JesseLevine727/pocketai/docs/figures/m6/platforms.pdf

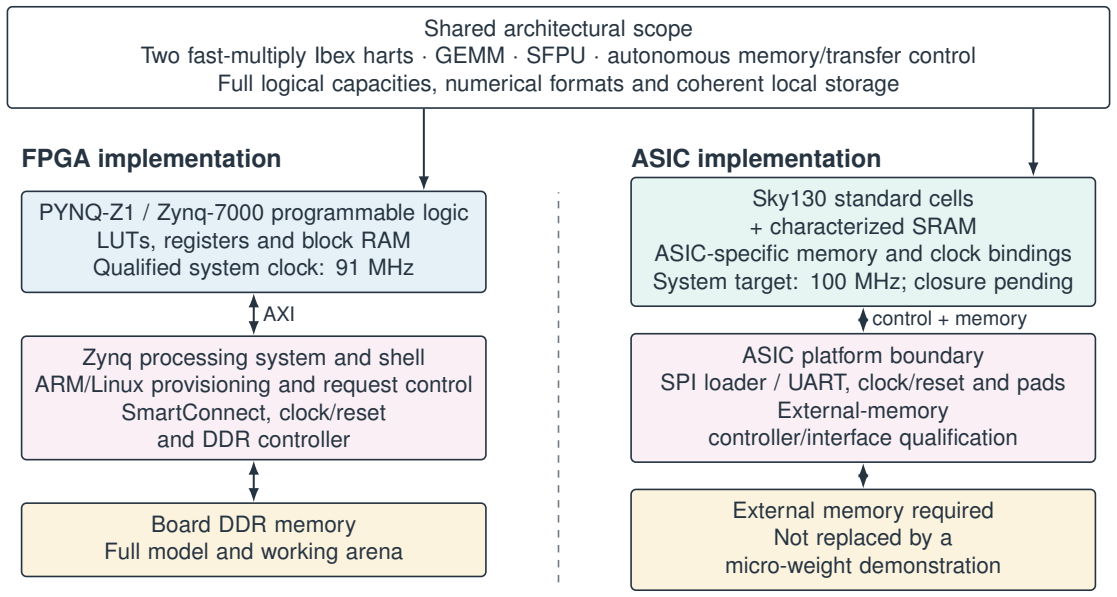
[picture p1: figure]
Shared architectural scope; FPGA implementation; ASIC implementation; PYNQ-Z1 / Zynq-7000 programmable logic LUTs, registers and block RAM Qualified system clock: 91 MHz; Sky130 standard cells + characterized SRAM ASIC-specific memory and clock bindings System target: 100 MHz; closure pending; Zynq processing system and shell ARM/Linux provisioning and request control SmartConnect, clock/reset and DDR controller; ASIC platform boundary SPI loader / UART, clock/reset and pads External-memory controller/interface qualification; AXI; control + memory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

Two fast-multiply Ibex harts · GEMM · SFPU · autonomous memory/transfer control Full logical capacities, numerical formats and coherent local storage

FPGA performance is measured on the board. ASIC area/timing are implementation-tool results; no fabricated ASIC, measured ASIC token rate or fabrication-ready claim is implied.
