JesseLevine727/pocketai/docs/M4_NUMERICS.md

# M4 model arithmetic — scaled v2 and range-safe adaptive v3

This is a **model-level representation**, composed from unchanged M3 v1
operators. It is not a change to `ref/sfpu_ref.py`, M3's packet ABI, its error
budgets, clock, or accepted overlay. Candidate implementation:
`ref/gpt2_scaled.py`. M4 quality limits were committed in `12f5386` before this
candidate was evaluated. The direct fixed-Q8 v1 failure remains preserved.

## Representations and boundaries

- Persistent activation payloads remain int16. Most tensors have logical
  value `raw / 256`. Residuals and final logits additionally carry a per-row
  exponent `e >= 0`, with logical value `raw * 2^e / 256`.
- GEMM inputs and weights are int8; reductions are exact signed int32 with
  K<=3072. No W8A16 or floating-point fabric is substituted.
- QKV and cached K/V remain Q8. K quantization uses a separate scale for each
  token; V quantization uses each feature over **only the causal prefix**.
  Future tokens cannot select the scale for an earlier output.
- Softmax remains M3's unsigned Q0.15, including positive 32768. The dynamic
  W8A8 bridge uses unsigned probabilities without signed reinterpretation.
- Embeddings, learned positions and biases come from the same pinned model.
  Final projection derives from the tied embedding weights, with a different
  quantized view after channel balancing; there are no newly trained or
  independently untied output weights.

The host study keeps int8 codes expanded to float64 for BLAS speed. This
represents all bounded integer dot-product sums exactly, as separately tested.
It is **not** a board memory layout or an acceptable 1-GiB A9 allocation.
The physical runtime must use bounded native int8 weights and scratch buffers.

## Channel balancing

For a linear input channel, choose positive `s` and replace the unquantized
linear function by `(x/s) @ (s*W)`. Train-only per-channel absolute maxima `a`
and weight-row maxima `w` give `s = a^alpha / w^(1-alpha)`, with nonzero floors.
The first development candidate uses **alpha=0.5**. A common scalar normalizes
the largest calibrated balanced activation to at most 64 and, for folded LN,
the largest gain magnitude to at most 7.5. This uses int16/gain resolution
without changing relative channel balancing. Out-of-calibration clipping is
still counted; the calibration bound is not presumed universal.

LN-to-QKV, LN-to-MLP-up and final-LN-to-vocabulary fold `gamma/s, beta/s`
into LN and `s*W` into the following weights. Attention-context and post-GELU
balancing require an explicit per-channel M3 AFFINE before requantization.
Scales are **not moved through GELU or softmax**. Weight quantization remains
symmetric, per output channel. The algebra is the idea studied by
[SmoothQuant](https://arxiv.org/abs/2211.10438v7); its published speed/quality
results are not evidence for this GPT-2/PYNQ implementation.

## Residual ranges and LayerNorm epsilon

A9 examines wide GEMM sums and their scale metadata before narrowing. The
smallest nonnegative exponent that gives at most 32700 raw magnitude is used.
For a residual addition, range selection bounds `abs(old) + abs(branch)` so
both addends and their sum fit. M3 AFFINE aligns the old residual and projects
the branch into the chosen units, followed by M3 ADD. Bias rounding and each
alignment/narrowing boundary are explicit. The headroom covers ordinary
rounding; saturation counters remain mandatory. Logits use one common exponent
across **all 50,257 vocabulary entries in each row**, not incomparable tile
scales. Wide scratch is temporary, not persistent activation storage.

Scaled LayerNorm cannot just ignore epsilon. Let `z=raw/256`, `c=2^e` and
`x=c*z`. M3 normalizes `z` with epsilon=1e-5. A9 multiplies the learned gain by

`sqrt((var(z)+epsilon) / (var(z)+epsilon/c^2))`.

This restores the desired epsilon algebra for the represented `x` before gain
quantization. The variance numerator `L*sum(raw^2)-sum(raw)^2` is computed in
integer arithmetic, avoiding subtractive floating-point cancellation. Constant
and near-constant vectors are tested. The gain is then rounded to M3 Q12.
If it exceeds the gain range, an explicit power-of-two decomposition performs
LN(gamma/factor,0), then AFFINE(factor,beta); its extra rounding is part of this
candidate. Otherwise M3's single rounding, **bias then saturation** is retained.
The fixed M3 integer square-root/epsilon rounding remains unchanged; model
quality must absorb the declared metadata/gain quantization, not hide it.

This introduces A9 variance/square-root/scale bookkeeping. It is a disclosed
hybrid assistance cost, not autonomous RISC-V inference or free computation.
Required metadata work belongs inside end-to-end inference measurements.

## Attention score centering

Rounded wide QK scores can exceed signed Q8 even when their relevant
differences are small. Before AFFINE saturation, A9 selects a common bias equal
to the negative maximum rounded raw score. This makes the maximum zero without
changing any score difference. AFFINE then saturates only far negative tails.
Such tails have differences above 32768 raw, already beyond M3's exact
4096-raw exponential cutoff; their represented probability was zero anyway.
These **intentional zero-tail clamps** are counted separately from unintended
clipping. Positive-score saturation before centering is not allowed.

## V3: bounded post-nonlinearity balancing

The 1024-token development stress found out-of-calibration overflow in block 0
context/post-GELU balancing, despite passing held-out quality on v2. V2 and its
failure evidence remain immutable. `ref/gpt2_adaptive.py` extends v2 only at
these balancing boundaries: prospectively compute the exact affine raw output
and use the original path when it fits int16. Otherwise choose a per-row
nonnegative exponent giving 32700 raw headroom and AFFINE by `1/(s*2^e)`.
Carry the unit `2^e/256` into the following dynamic-int8/GEMM scale metadata.
No nonlinear operation sees a different logical unit, and weights/calibration
are unchanged. The extra range scan is required A9 work, not excluded overhead.

V3 reproduces **all 2,048 development logits and caches exactly** from v2, and
passes the 1024-position full/chunked cache test with **zero clipping**. The
v3 source and selection evidence are frozen in `tests/m4/adaptive_candidate.json`
before requalification on the same held-out set, which now **passes** with
exactly the same reported quality metrics and all generation logit hashes.
All packed weight/metadata arrays also remain identical. V2 held-out results were
already known; this is a transparent functional correction based on development
stress, not a new blind benchmark or calibration/threshold change.

## Acceptance status and physical qualification

### Runtime batching without a numerical change

The bounded runtime batches independent dynamic-int8 columns using M3 AFFINE
with per-lane multipliers and zero bias at shift 24. This is exactly the frozen
REQUANT8 bridge, not a new quantizer: for `a=max(abs(raw))<=32768` and
`m=RNE(127*2^24/a)`, the endpoint before final RNE is within
`127 +/- 0.0009765625`. Therefore every rounded result is in [-127,127]; neither
the REQUANT8 int8 clamp nor AFFINE int16 clamp activates. Zero columns retain
multiplier zero and effective-unit fallback 1. The returned codes and scales
are unchanged. Runtime checks the bound before casting to int8.

Tests exhaust all 32,768 nonzero maxima, both signs and interior values,
unsigned probability 32768, zero columns, full shapes and packet tails. Whole
model layer/logit/KV and 60-token generation checks remain exact. Batching is
used only when it reduces descriptor count; larger row vectors retain REQUANT8.
Extra AFFINE multiplier/bias transfer planes are real traffic and must be timed.
The representative host qualification drops SFPU dispatches from 1,060,844 to
113,420 (89.3% fewer), **not a measured system-speedup claim**.

Unit tests establish scaling algebra, exact M3 affine/LN behavior, range
selection and zero-tail equivalence. Real-checkpoint cached/full-prefill and
independent float comparisons pass as recorded in `M4_VERIFICATION.md`, including
8,192 held-out predictions and all 60 generated cache/recomputation steps. The
source/calibration policy was frozen before held-out testing; thresholds were
not tuned. The compact model-pack serialization is verified. Physical-board
equivalence now passes on the exact accepted overlay: actual-operand checks,
four complete tensor cases, three 20-token generation/logit/KV sequences and
the full 1024-position/cache/overflow test. Host quality remains a separate
gate from delivered integer self-consistency. Full evidence is in
`M4_VERIFICATION.md`; actual measured performance and slowdowns are in `SPEEDUP.md`.
