JesseLevine727/pocketai/docs/evidence/m6_memory_resumed_v2/failed_leaf_disconnected.txt

┏━━━━━━━━━━━━━━━━━┳━━━━━━━━━━━━┳━━━━━━━━━━━━━━━━━━━━━━┳━━━━━━━━━━━━━━━━━━━┳━━━━━━━━━━━━━━┓
┃ Macro/Instance  ┃ Power Pins ┃ Disconnected         ┃ Signal Pins       ┃ Disconnected ┃
┡━━━━━━━━━━━━━━━━━╇━━━━━━━━━━━━╇━━━━━━━━━━━━━━━━━━━━━━╇━━━━━━━━━━━━━━━━━━━╇━━━━━━━━━━━━━━┩
│ m6_leaf_0_pre   │            │ m6_leaf_0_pre/VGND   │ m6_leaf_0_pre/A   │              │
│                 │            │ m6_leaf_0_pre/VNB    │ m6_leaf_0_pre/Y   │              │
│                 │            │ m6_leaf_0_pre/VPB    │                   │              │
│                 │            │ m6_leaf_0_pre/VPWR   │                   │              │
├─────────────────┼────────────┼──────────────────────┼───────────────────┼──────────────┤
│ m6_leaf_0_drive │            │ m6_leaf_0_drive/VGND │ m6_leaf_0_drive/A │              │
│                 │            │ m6_leaf_0_drive/VNB  │ m6_leaf_0_drive/Y │              │
│                 │            │ m6_leaf_0_drive/VPB  │                   │              │
│                 │            │ m6_leaf_0_drive/VPWR │                   │              │
├─────────────────┼────────────┼──────────────────────┼───────────────────┼──────────────┤
│ m6_leaf_1_pre   │            │ m6_leaf_1_pre/VGND   │ m6_leaf_1_pre/A   │              │
│                 │            │ m6_leaf_1_pre/VNB    │ m6_leaf_1_pre/Y   │              │
│                 │            │ m6_leaf_1_pre/VPB    │                   │              │
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
│                 │            │ m6_leaf_7_drive/VPB  │                   │              │
│                 │            │ m6_leaf_7_drive/VPWR │                   │              │
└─────────────────┴────────────┴──────────────────────┴───────────────────┴──────────────┘
