JesseLevine727/pocketai/docs/figures/m6/architecture.pdf

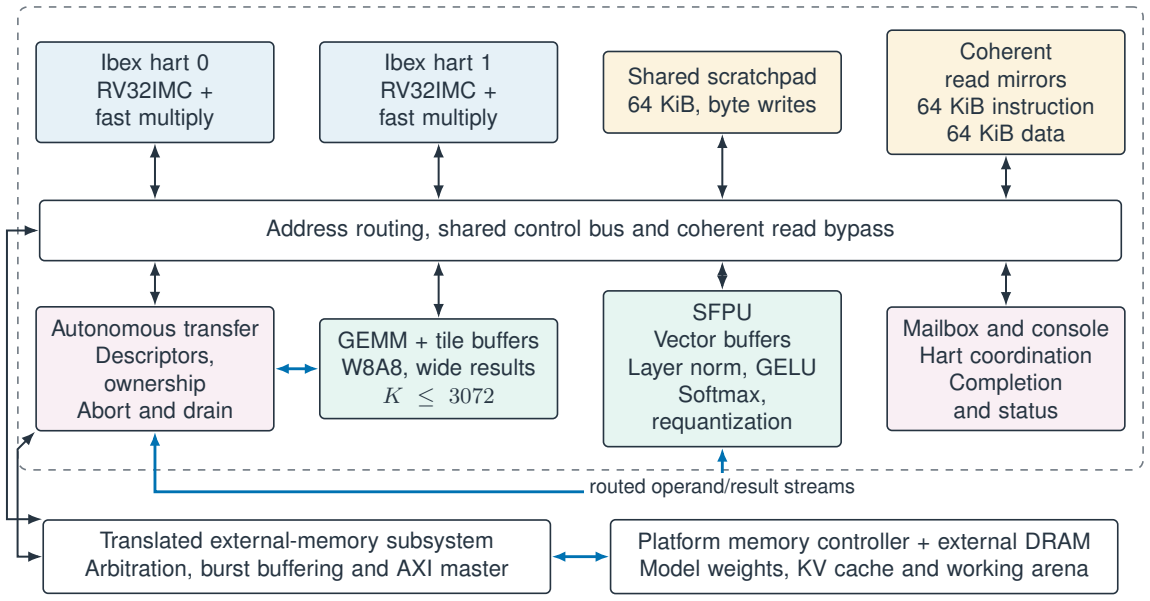
[picture p2: figure]
Ibex hart 0 RV32IMC + fast multiply; Ibex hart 1 RV32IMC + fast multiply; Shared scratchpad 64 KiB, byte writes; Coherent read mirrors 64 KiB instruction 64 KiB data; Autonomous transfer Descriptors, ownership Abort and drain; GEMM + tile buffers W8A8, wide results K ≤ 3072; SFPU Vector buffers Layer norm, GELU Softmax, requantization; Mailbox and console Hart coordination Completion and status; routed operand/result streams; Translated external-memory subsystem

Address routing, shared control bus and coherent read bypass

Arbitration, burst buffering and AXI master

Platform memory controller + external DRAM Model weights, KV cache and working arena

Portable inference compute and local storage

Functional abstraction: the central band summarizes distinct control, routing and bypass paths. External DRAM is not included in on-chip SRAM area. FPGA/ASIC bindings differ.
