JesseLevine727/pocketai/docs/figures/m6/asic_floorplan.pdf

## PocketAI: retained ASIC macro floorplan

Actual OpenDB coordinates · 292 SRAM macros · historical 2× adapter candidate

G | G | G | G | G | G | G | G | G | G | G | G | G | G | G | G | G
G | G | G | G | G | G | G | G | G | G | G | G | G | G | G | G | G
G | G | G | G | G | G | G | G | G | G | G | G | G | G | G | G | G
G | G | G | G | G | G | G | G | G | G | G | G | G | G | G | G | G
G | G | G | G | G | G | G | G | G | G | G | G | G | G | G | G | G
G | G | G | G | G | G | G | G | G | G | G | G | G | G | G | G | G
G | G | G | G | G | G | G | G | G | G | S | S | S | S | S | S | S
S | S | S | S | S | S | S | S | S | S | S | D | D | D | D | D | D
D | D | D | D | D | D | D | D | D | D | D | D | D | D | D | D | D
D | D | D | D | D | D | D | D | D | D | D | D | D | D | D | D | D
D | D | D | D | D | D | D | D | D | D | D | D | D | D | D | D | D
D | D | D | D | D | D | D | I | I | I | I | I | I | I | I | I | I
I | I | I | I | I | I | I | I | I | I | I | I | I | I | I | I | I
I | I | I | I | I | I | I | I | I | I | I | I | I | I | I | I | I
I | I | I | I | I | I | I | I | I | I | I | I | I | I | I | I | I
I | I | I | B | B | R | R | R | R | R | R | R | R | R | R | R | R
R | R | R | R | R | R | R | R | R | R | R | R | R | R | R | R | R
R | R | R

### Memory ownership

G GEMM
112 macros

S SFPU
18 macros

R Scratchpad
32 macros

I Instruction mirror
64 macros

D Data mirror
64 macros

B Burst buffer
2 macros

9.1 × 9.9 mm core frame
584 KiB physical SRAM
Both read copies included

Macro placement + PDN only Standard cells not placed
Signal routing not complete No pads in this core view
100-MHz closure: pending

Source: m6_core_physical_v4 / floorplan_v1 / OpenROAD.GeneratePDN
Labels and colors identify ownership; all macro positions and dimensions come from the retained database.
