JesseLevine727/pocketai/docs/figures/m6/asic_openroad.png

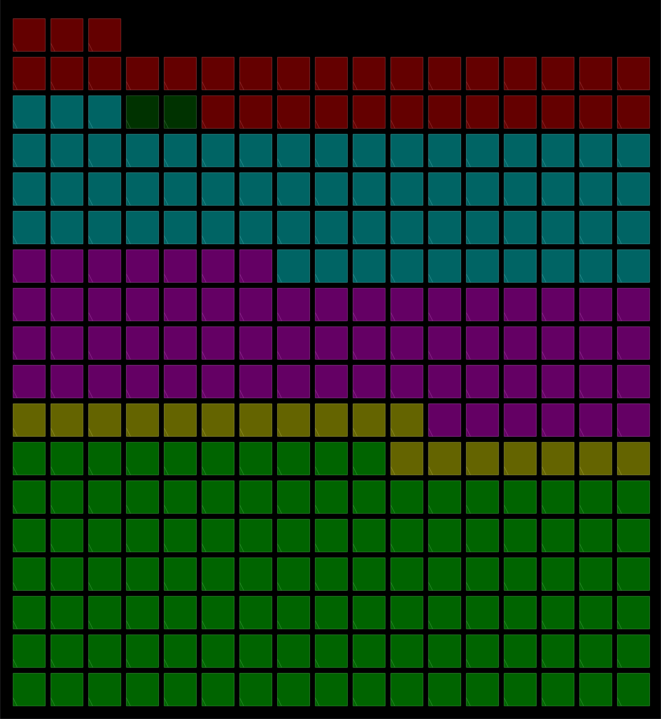
docs/figures/m6/asic_openroad.png
