JesseLevine727/pocketai/docs/m5_sweep_samples.csv

id | kind | status | role | reason | case_elapsed_seconds | bound_exceeded | prompt_tokens | new_tokens | past | profiled | model_first_token_seconds | prefill_seconds | prefill_tokens_per_second | continuation_tokens | continuation_seconds | continuation_tokens_per_second | workspace_bytes | input_bytes | output_bytes | jobs | traffic_scope | model_seconds | model_cycles | delivered_seconds | host_minus_model_seconds | model_tokens_per_second | delivered_tokens_per_second
story_g2_r1 | full | PASS | original_anchor |  | 74.62860818905756 | False | 13 | 2 |  | False | 64.27060191208791 | 64.19808389010988 | 0.2024982555905026 | 1 | 8.892870153846154 | 0.11244963467362687 | 2302532 | 368208024 | 22779400 | 35686 | packet byte counters modulo 2^32; not total DDR traffic | 73.16347561538461 | 6657876281 | 74.22159438207746 | 1.0581187666928429 | 0.027336044155609328 | 0.026946335721439944
science_g1_r1 | full | PASS | original_anchor |  | 41.571153949946165 | False | 8 | 1 |  | False | 40.37491806593407 | 40.30238657142857 | 0.19849941109123825 | 0 | 0 |  | 2187332 | 192033228 | 12931268 | 19200 | packet byte counters modulo 2^32; not total DDR traffic | 40.37492246153846 | 3674117944 | 41.42988930083811 | 1.0549668392996523 | 0.024767849423181176 | 0.024137163214186293
computing_g1_r1 | full | PASS | original_anchor |  | 41.59680227609351 | False | 8 | 1 |  | False | 40.399335395604396 | 40.328342472527474 | 0.19837165401602533 | 0 | 0 |  | 2187332 | 192033228 | 12931268 | 19200 | packet byte counters modulo 2^32; not total DDR traffic | 40.39933972527473 | 3676339915 | 41.454673684202135 | 1.055333958927406 | 0.024752879794576882 | 0.02412273239967844
cached_p13_plain_r1 | cached | PASS | injected_valid_cache |  | 13.443841483909637 | False |  | 1 | 13 | False |  |  |  |  |  |  | 2026052 | 134861772 | 1981892 | 9701 | packet word counters modulo 2^32, multiplied by 4; not total DDR traffic | 8.897048307692307 | 809631396 | 9.953339073807001 | 1.056290766114694 | 0.1123968270617806 | 0.10046879671080222
cached_p13_plain_r2 | cached | PASS | injected_valid_cache |  | 11.759177303873003 | False |  | 1 | 13 | False |  |  |  |  |  |  | 2026052 | 134861772 | 1981892 | 9701 | packet word counters modulo 2^32, multiplied by 4; not total DDR traffic | 8.896981076923076 | 809625278 | 9.955056087113917 | 1.0580750101908407 | 0.11239767639764825 | 0.10045146820362227
cached_p13_plain_r3 | cached | PASS | injected_valid_cache |  | 11.78972486173734 | False |  | 1 | 13 | False |  |  |  |  |  |  | 2026052 | 134861772 | 1981892 | 9701 | packet word counters modulo 2^32, multiplied by 4; not total DDR traffic | 8.900629362637362 | 809957272 | 10.019182230345905 | 1.1185528677085426 | 0.11235160562889546 | 0.0998085449500279
story_length_1_g1_r1 | full | PASS | synthetic_prefill_length |  | 9.938141838181764 | False | 1 | 1 |  | False | 8.557182494505495 | 8.484665582417582 | 0.11785968348266526 | 0 | 0 |  | 2026052 | 134705100 | 1966916 | 9701 | packet byte counters modulo 2^32; not total DDR traffic | 8.557186912087912 | 778704009 | 9.612499672919512 | 1.0553127608315993 | 0.11686083408875836 | 0.1040312129026351
story_length_16_g1_r1 | full | PASS | synthetic_prefill_length |  | 80.8768947427161 | False | 16 | 1 |  | False | 79.67211686813187 | 79.59960054945054 | 0.2010060338187268 | 0 | 0 |  | 2371652 | 258277836 | 25531076 | 30056 | packet byte counters modulo 2^32; not total DDR traffic | 79.67212120879121 | 7250163030 | 80.72361014643684 | 1.0514889376456296 | 0.012551441894955568 | 0.012387949426270056
story_length_32_g1_r1 | full | PASS | synthetic_prefill_length |  | 174.07728742389008 | False | 32 | 1 |  | False | 172.84272452747254 | 172.77020702197802 | 0.18521711903678678 | 0 | 0 |  | 2371652 | 522159000 | 51504520 | 62416 | packet byte counters modulo 2^32; not total DDR traffic | 172.84272886813187 | 15728688327 | 173.9044179469347 | 1.0616890788028286 | 0.00578560640964502 | 0.005750285195774271
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
