JesseLevine727/pocketai/docs/figures/m6/vivado_system.pdf

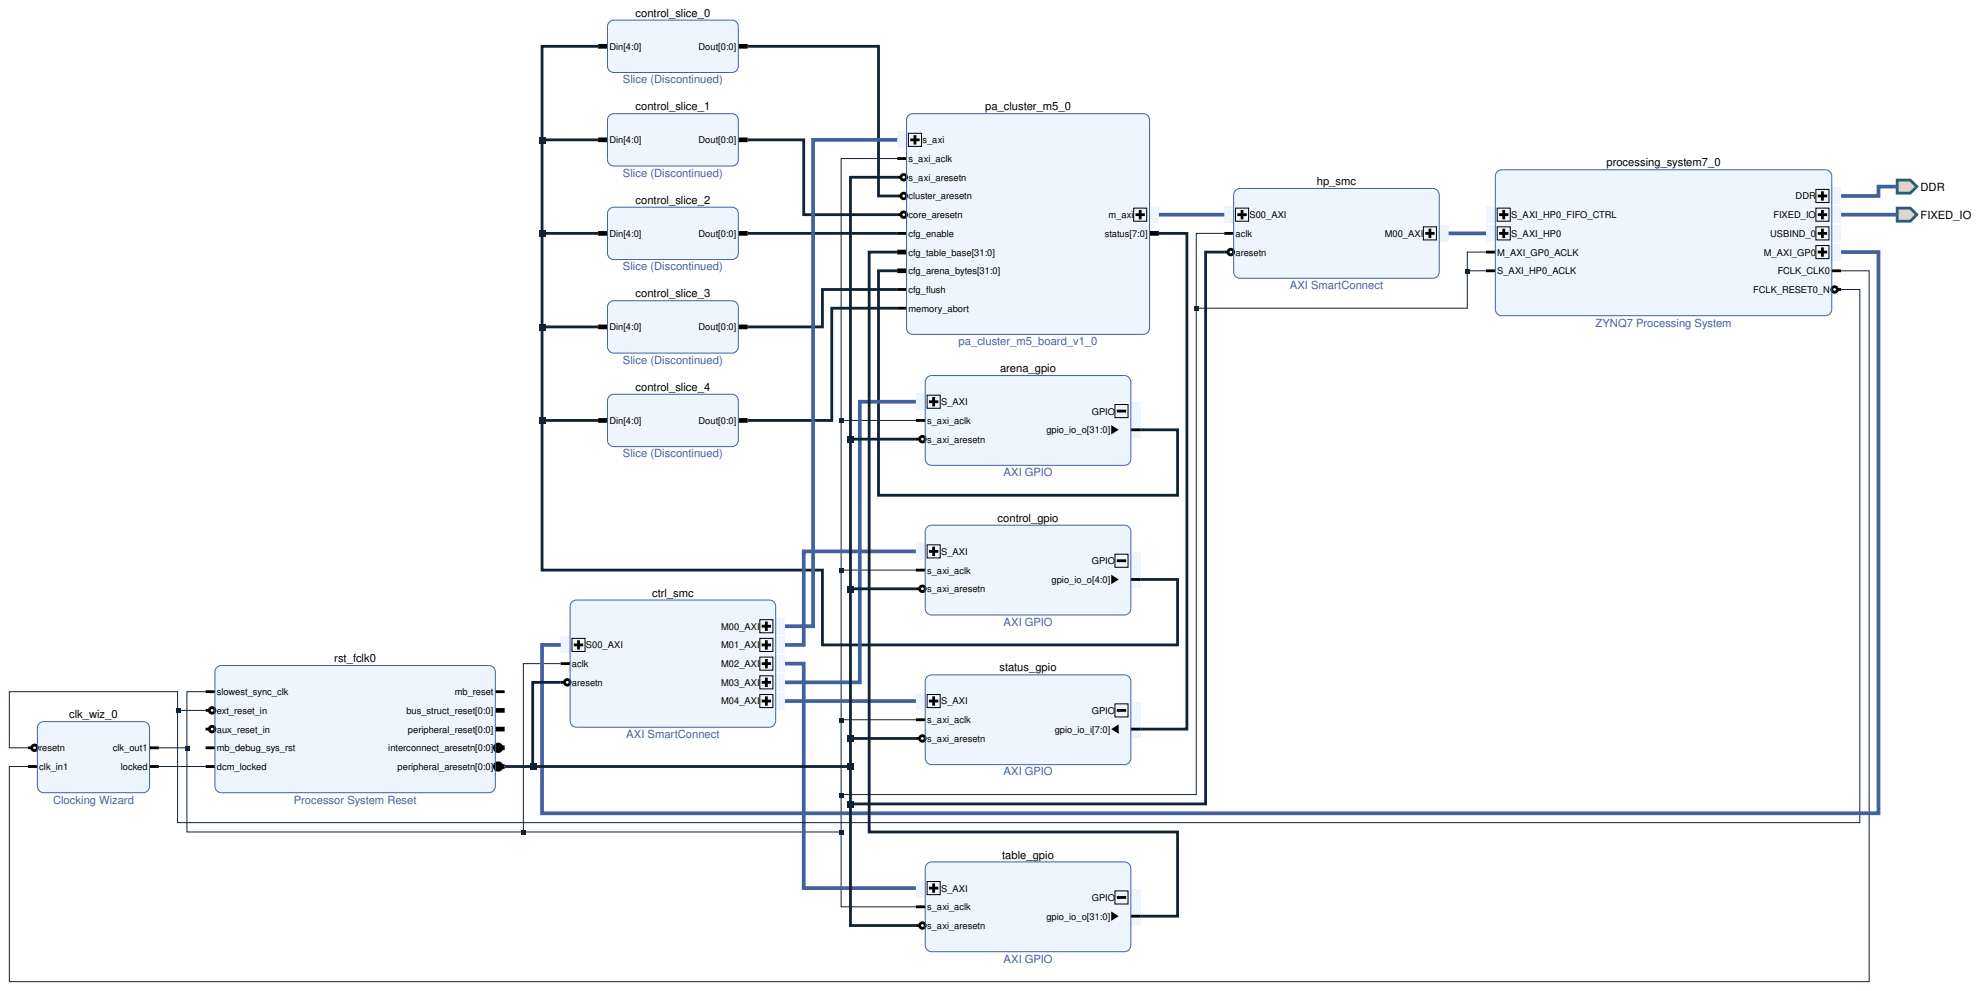
[picture p4: page 1]
clk_wiz_0; Clocking Wizard; resetn; clk_in1; clk_out1; locked; rst_fclk0; slowest_sync_clk; ext_reset_in; aux_reset_in; mb_debug_sys_rst; dcm_locked; mb_reset; bus_struct_reset[0:0]; peripheral_reset[0:0]; interconnect_aresetn[0:0]; peripheral_aresetn[0:0]; control_slice_0; Slice (Discontinued); Din[4:0]; Dout[0:0]; control_slice_1; control_slice_2; control_slice_3; control_slice_4; ctrl_smc; AXI SmartConnect; S00_AXI; M00_AXI; M01_AXI; M02_AXI; M03_AXI; M04_AXI; aclk; aresetn; pa_cluster_m5_0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

Processor System Reset
