JesseLevine727/pocketai/scripts/audit_m5_startup.py

"""Read-only startup measurement checks; collection never implies closure by itself."""
import argparse
import json
import math
from pathlib import Path
import re
import subprocess
import sys

from scripts.m5_sweep_policy import ROOT, sha
from scripts.audit_m5_sweep import require, finite_positive
from scripts.audit_m5_context import stats


def read(path):
    return json.loads((ROOT/path).read_text())


def validate_campaign(report, refs):
    p = report['policy']
    require(report['status'] == refs['status'] == 'PASS' and report['within_budget'] and
            0 < report['elapsed_seconds'] <= 3600 and p['board_budget_seconds'] == 3600 and
            p['cleanup_reserve_seconds'] == 120, 'campaign/budget gate')
    require(report['clock_hz'] == p['clock_hz'] == 91000000 and
            report['allocated_bytes'] == 266289152, 'clock/arena changed')
    require(report['normal_unload'] and not report.get('cleanup_error') and
            report['dma_after_return']['owner'] == 0 and
            all(report['info_after_close_reopen'][k] == 0 for k in ('owner', 'allocated_pages', 'pte_dma')),
            'normal ownership/page/PTE release missing')
    require(report['policy_sha256'] == refs['policy_sha256'], 'oracle/policy mismatch')
    require(all(report['sha256'][name] == value for name, value in p['pinned'].items()),
            'executed file differs from frozen policy')
    reject = report['boundary_rejection']
    require(reject['state'] == 5 and reject['error'] == 1 and reject['cache_valid'] == 17 and
            reject['generated_count'] == 19 and reject['output_sentinel_unchanged'] and
            set(reject['cache_regions_unchanged']) == {'k', 'v', 'k8', 'kunits'} and
            reject['recovery'] == 'subsequent accepted runs', 'overflow non-mutation/recovery missing')
    require([i['trial'] for i in report['trials']] == p['matrix'], 'missing/reordered trials')
    previous = None
    for item in report['trials']:
        t, r = item['trial'], item['result']
        require(item['status'] == 'PASS' and not item['bound_exceeded'] and
                0 < item['case_elapsed_seconds'] <= t['bound_seconds'] and
                item['started_campaign_seconds'] >= 0 and
                item['started_campaign_seconds']+t['bound_seconds']+120 <= 3600,
                'trial/bounded admission gate')
        if t['kind'] == 'cached':
            seed = refs['seeds'][str(t['past'])]
            expected = seed['expected']
            tokens = seed.get('prefill_tokens', [seed.get('input_token')])
            require(r['status'] == 'PASS' and r['initial_past'] == t['past'] and
                    r['input_tokens'] == tokens and r['cache_valid'] == t['past']+len(tokens) and
                    r['token'] == expected['token'] and
                    r['firmware_sha256'] == p['pinned']['m5_profile.bin'], 'cached identity/input/output')
            require(r['context_role'] == seed['context_role'], 'cached request boundary changed')
            if r['context_role'] == 'warm_last_slot':
                require(previous is not None and previous['cache_valid'] == seed['past'] and
                        previous['token'] == seed['input_token'] and
                        previous['kv_sha256'] == seed['prefill_kv_sha256'], 'hidden/future/unmatched warm state')
                require(r['derived_cache']['appended_vectors'] == 288 and
                        r['derived_cache']['updated_columns'] >= previous['derived_cache']['updated_columns'],
                        'warm state was reset')
            else:
                require(r['derived_cache']['appended_vectors'] == 144*len(tokens), 'cold/prefill row coverage')
            require(r['derived_cache']['cold_heads'] == 144, 'incomplete head coverage')
            model, delivered = r['model_seconds'], r['host_request_through_delivery_seconds']
            require(model == r['model_cycles']/91000000 and r['profile_enabled'] == t['profile'],
                    'cycle/profile boundary changed')
            require(r['workspace_high_water'] <= 2609152, 'workspace bound exceeded')
            if t['profile']:
                phases = r['phases']
                order = [(1, 0)]+[(kind, layer) for layer in range(12) for kind in range(2, 10)]
                order += [(10, 0), (11, 0), (12, 0)]
                require([(x['kind'], x['layer']) for x in phases] == order, 'phase coverage')
                for x in phases:
                    require(0 <= x['gemm_cycles']+x['sfpu_cycles'] <= x['service_cycles'] <= x['cycles'] and
                            x['cpu_remainder_cycles'] == x['cycles']-x['service_cycles'], 'nested phase accounting')
                require(sum(x['cycles'] for x in phases)+r['unassigned_profile_tail_cycles'] ==
                        r['model_cycles'], 'missing model cycles')
                for counter, seconds in (('service_cycles', 'service_seconds'),
                        ('gemm_cycles', 'gemm_compute_seconds'), ('sfpu_cycles', 'sfpu_compute_seconds')):
                    require(sum(x[counter] for x in phases)/91000000 == r[seconds], 'nested service totals')
                require(math.isclose(r['service_seconds']+r['cpu_remainder_seconds'], model, abs_tol=1e-9),
                        'model/service sum')
                details = r['startup_detail']
                require(all(x['seconds'] == x['cycles']/91000000 for x in details), 'detail cycle conversion')
                if r['derived_cache'].get('version', 1) == 2:
                    require(len(details) == 16, 'missing deferred first-use counters')
                    cold = r['context_role'] != 'warm_last_slot'
                    for index, count in {0: 144 if cold else 0, 13: 12,
                                         14: 144 if cold else 0, 15: 144*len(tokens)}.items():
                        require(details[index]['calls'] == count, 'first-use coverage')
                    required = details[13]['seconds']+details[14]['seconds']
                    require(r['initial_required_derived_seconds'] == required and 0 <= required <= model and
                            details[14]['cycles'] <= details[15]['cycles'], 'hidden first-demand work')
            else:
                require(not r['phases'] and r['service_seconds'] is None and
                        'startup_detail' not in r, 'profile contaminated plain sample')
            previous = r
        else:
            require(t['kind'] == 'full', 'unknown trial type')
            case = refs['cases'][t['case']]
            count = t['new_tokens']; expected = case['steps'][count-1]
            require(r['id'] == case['id'] and r['prompt_tokens'] == case['input_tokens'] and
                    r['generated_tokens'] == [x['token'] for x in case['steps'][:count]] and
                    r['cache_valid'] == len(case['input_tokens'])+count-1, 'original request changed')
            image = 'm5_trace.bin' if t['capture'] else 'm5_runtime.bin'
            require(r['execution_image'] == image and r['firmware_sha256'] == p['pinned'][image],
                    'full request image changed')
            if t['capture']:
                baseline = read('build/m5_startup_split_fixed_diag_v1/campaign.json')
                expected_trace = next(x['result']['traces'] for x in baseline['trials']
                                      if x['trial'].get('capture'))
                require(r['traces'] == expected_trace, 'original story tensors changed')
            model, delivered = r['firmware_seconds'], r['request_through_delivery_seconds']
            require(len(r['decode_seconds']) == count-1 and
                    math.isclose(r['ttft_seconds']+sum(r['decode_seconds']), model, abs_tol=.001) and
                    r['request_tokens_per_second'] == count/delivered, 'full-request accounting')
            require(r['work_high_water'] <= 2609152, 'full request workspace bound')
            previous = None
        require(finite_positive(model) and finite_positive(delivered) and
                model < delivered <= item['case_elapsed_seconds'], 'invalid delivery interval')
        require(r['logits_sha256'] == expected['logits_sha256'] and
                r['kv_sha256'] == expected['cache_sha256'], 'all logits/complete valid KV mismatch')


def validate_final(reports, references, selection, binaries, overlay):
    """Every selected repetition must pass; averages cannot conceal a miss."""
    all_full = []
    for prefix in ('story', 'science'):
        key = selection['final_'+prefix]
        report = reports[key]; refs = references[key]
        require(refs['case'] == prefix, 'independent prefix changed')
        pinned = report['policy']['pinned']
        require(all(pinned[n] == overlay[n] for n in overlay), 'final hardware identity')
        require(all(pinned[n] == binaries[n] for n in ('m5_runtime.bin', 'm5_profile.bin', 'm5_trace.bin')),
                'final firmware identity')
        for past, limit in ((1022, 20.0), (1023, 10.0)):
            group = [x for x in report['trials'] if x['trial'].get('past') == past]
            require(len(group) >= 3 and all(not x['trial']['profile'] and
                    x['result']['derived_cache'].get('version') == 2 and
                    x['result']['host_request_through_delivery_seconds'] <= limit for x in group),
                    'cold/warm repeated per-sample performance gate')
        all_full += [x for x in report['trials'] if x['trial']['kind'] == 'full']
        diagnostic = reports[selection['diagnostic_'+prefix]]
        require(references[selection['diagnostic_'+prefix]]['case'] == prefix, 'diagnostic prefix')
        require(diagnostic['policy']['pinned']['m5_profile.bin'] == binaries['m5_detail.bin'] and
                all(diagnostic['policy']['pinned'][n] == overlay[n] for n in overlay), 'diagnostic image')
        cold = [x for x in diagnostic['trials'] if x['trial'].get('past') == 1022]
        require(cold and all(x['trial']['profile'] and
                x['result']['initial_required_derived_seconds'] <= 10.0 and
                x['result']['host_request_through_delivery_seconds'] <= 20.0 for x in cold),
                'cold initialization diagnostic gate')
    for name, tokens, seconds in (('science', 1, 10.0), ('computing', 1, 10.0), ('story', 2, 20.0)):
        group = [x for x in all_full if x['trial']['case'] == name and not x['trial']['capture']]
        require(len(group) >= 3 and all(x['trial']['new_tokens'] == tokens and
                x['result']['request_through_delivery_seconds'] <= seconds for x in group),
                'original short-request repeated performance gate: '+name)
    require(any(x['trial']['case'] == 'story' and x['trial']['capture'] for x in all_full),
            'final original physical story trace missing')


def validate_stage(stage):
    stage = Path(stage)
    report, refs = read(stage/'campaign.json'), read(stage/'references/manifest.json')
    validate_campaign(report, refs)
    validate_references(refs)
    layout = Path('build/m5_arena.1Org4t/model/layout.json')
    require(report['sha256']['model.bin'] == read(layout)['model_sha256'] and
            report['sha256']['layout.json'] == sha(ROOT/layout), 'complete model/layout identity changed')
    require(report['policy'] == read(stage/'policy.json') and
            report['policy_sha256'] == sha(ROOT/stage/'policy.json') and
            report['reference_manifest_sha256'] == sha(ROOT/stage/'references/manifest.json'),
            'measured policy/reference binding')
    for name, digest in report['policy']['pinned'].items():
        path = ROOT/stage/'deployed'/name if name.endswith('.py') else ROOT/report['policy']['source_paths'][name]
        require(sha(path) == digest, 'historical deployed artifact changed: '+str(path))
    return report, refs


def validate_references(refs):
    require(refs['case'] in ('story', 'science'), 'unknown independent prefix')
    directory = 'build/m5_context_'+refs['case']+'_reference_v'+('2' if refs['case'] == 'story' else '1')
    canonical = read(directory+'/manifest.json')
    for past in ('1022', '1023'):
        require(refs['seeds'][past] == canonical['seeds'][past], 'independent maximum-context oracle changed')
    fixtures = {x['id']: x for x in read('build/m4_runtime_fixtures/manifest.json')['generation']}
    require(refs['cases'] == fixtures, 'original full-request oracles changed')
    prompt = refs['seeds']['0']
    require(any(prompt['prefill_tokens'] == case['input_tokens'] and prompt['expected'] == case['steps'][0]
                for case in fixtures.values()), 'actual prefill oracle changed')


def hardware_from_reports(directory, reset_count=9, data_read_mirror=False):
    def text(name): return (ROOT/directory/'reports'/name).read_text()
    timing = text('m5_timing_summary.rpt')
    m = re.search(r'WNS\(ns\).*?\n\s*-+[^\n]*\n\s*([^\n]+)', timing, re.S)
    require(m, 'missing timing summary')
    v = m[1].split()
    result = dict(wns_ns=float(v[0]), tns_ns=float(v[1]), hold_ns=float(v[4]), ths_ns=float(v[5]), clock_mhz=91)
    require('10.989          91.000' in timing and
            len(set(re.findall(r'\d+\. checking \w+ \(0\)', timing))) == 12 and
            'All user specified timing constraints are met.' in timing, 'timing constraints incomplete')
    route = text('m5_route_status.rpt')
    counts = [int(re.search(label+r'\.+\s*:\s*(\d+)', route)[1]) for label in
              ('# of routable nets', '# of fully routed nets', '# of nets with routing errors')]
    require(counts[0] == counts[1] and counts[0] > 0 and counts[2] == 0, 'incomplete routing')
    result['routed_nets'] = counts[0]
    utilization = text('m5_utilization.rpt')
    for key, label in (('luts', 'Slice LUTs'), ('registers', 'Slice Registers'),
                       ('bram36', 'Block RAM Tile'), ('dsp', 'DSPs'), ('slices', 'Slice')):
        found = re.search(r'\|\s*'+label+r'\s*\|\s*([\d.]+)\s*\|', utilization)
        require(found, 'missing utilization '+label); result[key] = float(found[1])
    for name, rule, count in (('m5_drc.rpt', 'RTSTAT-10', 1), ('m5_methodology.rpt', 'LUTAR-1', reset_count)):
        rules = re.findall(r'^\|\s*([A-Z][A-Z0-9-]+)\s*\|\s*(Warning|Error|Critical Warning)\s*\|[^\n]+?\|\s*(\d+)\s*\|', text(name), re.M)
        require(rules == [(rule, 'Warning', str(count))], 'unreviewed DRC/methodology finding')
    require(result['wns_ns'] >= .250 and result['tns_ns'] == 0 and result['hold_ns'] > 0 and
            result['ths_ns'] == 0 and result['dsp'] == 0 and
            result['bram36'] == (127.5 if data_read_mirror else 111.5),
            'hardware timing/resource gate')
    config = text('m5_fast_synth_configuration.rpt')
    for hart in (0, 1):
        require(f'hart={hart} multiplier=RV32MFast cells=91' in config, 'two fast harts not proven')
    require('fetch_mirror_bytes=65536 bram36=16 bram18=0' in config, 'unexpected instruction mirror')
    if data_read_mirror:
        require('data_read_mirror_bytes=65536 bram36=16 bram18=0' in config,
                'dedicated data-read bank not proven')
    for name in ('m5_pynq.bit', 'm5_pynq.hwh', 'm5_pynq_final.dcp'):
        require((ROOT/directory/name).is_file(), 'no qualified final '+name)
    return result


def manifest_paths():
    sources = set()
    for pattern in ('runtime/m5_startup/*', 'scripts/*m5_startup*', 'zynq/*m5_startup*',
                    'tests/m5_startup/*', 'docs/M5_STARTUP*.md'):
        sources.update(str(p.relative_to(ROOT)) for p in ROOT.glob(pattern) if p.is_file())
    artifacts = set()
    for directory in ROOT.glob('build/m5_startup_*'):
        entries = directory.rglob('*') if directory.is_dir() else (directory,)
        for p in entries:
            # Historical stage symlinks can target current Python sources.
            # Archive actual deployed files instead; canonical immutable binary
            # targets and each policy's exact identity are checked separately.
            if p.is_file() and not p.is_symlink() and '__pycache__' not in p.parts:
                artifacts.add(str(p.relative_to(ROOT)))
    return sources, artifacts


def summarize(reports):
    result = {}
    for name, report in reports.items():
        r = dict(status=report['status'], elapsed_seconds=report['elapsed_seconds'], cached={}, full=[])
        for role in ('cold_initialization_in_model', 'warm_last_slot', 'actual_prompt_prefill'):
            samples = [x['result'] for x in report['trials'] if x['trial']['kind'] == 'cached' and
                       x['result']['context_role'] == role]
            if samples:
                r['cached'][role] = dict(delivered=stats([x['host_request_through_delivery_seconds'] for x in samples]),
                    model=stats([x['model_seconds'] for x in samples]),
                    initial_required_seconds=[x['initial_required_derived_seconds'] for x in samples
                                              if 'initial_required_derived_seconds' in x])
        for item in report['trials']:
            t, x = item['trial'], item['result']
            if t['kind'] == 'full':
                r['full'].append(dict(id=t['id'], case=t['case'], output_tokens=t['new_tokens'],
                    trace=t['capture'], model_seconds=x['firmware_seconds'],
                    delivered_seconds=x['request_through_delivery_seconds'],
                    delivered_output_tokens_per_second=t['new_tokens']/x['request_through_delivery_seconds']))
        result[name] = r
    return result


NATIVE = {'attention_test.log': 'M5 SCALAR ATTENTION LAYOUT EXACT PASS 15',
    'native_test.log': 'M5 NUMERICAL FOUNDATION PASS',
    'ready_test.log': 'STARTUP LAZY CONTRACT PASS 32',
    'combined_test.log': 'CONTEXT COMBINED SCORES EXACT PASS 84',
    'ops_test.log': 'STARTUP GENERIC SCALAR EXACT PASS 96',
    'bounded_test.log': 'STARTUP BOUNDED PRODUCT EXACT PASS 462147',
    'word_test.log': 'STARTUP WORD AFFINE EXACT PASS 300000',
    'project_test.log': 'STARTUP FUSED PROJECT EXACT PASS 1776 accepted rows; 1686 fallback',
    'product_test.log': 'STARTUP PRODUCT TWO-ROUNDING EXACT PASS 330000',
    'batch_test.log': 'STARTUP BATCH EXACT PASS 20 accepted; 120 rejections',
    'fixed_test.log': 'STARTUP FIXED FACTOR EXACT PASS 500000'}
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
