JesseLevine727/pocketai/scripts/m5_startup_fetch.py

"""Coherent local instruction mirror; preserve all frozen CPU/router/bus sources."""
import argparse
import json
from pathlib import Path
import sys
import yaml
if __package__ in (None, ''):
    sys.path.insert(0, str(Path(__file__).resolve().parents[1]))
from scripts.m5_fast_sources import ROOT, WRAPPER, CLUSTER, derived_wrapper, pinned, digest, pipelined_multiplier
from scripts.m5_fast_sources import board_tcl as parent_board_tcl
from scripts.m5_iterate_sources import once
from scripts.check_m5_sources import check as check_lsu

TOP = 'src/pocketai_pa_pa_m5_rtl_0.1/pa_m5_cluster_top.sv'
MEMORY = Path(TOP).parent
ROUTER_SHA = '73e114d4902ed1ef4bce5bf5df108cd3c02caf402e84d7f5de49836419bdbbdb'
SYSTEM_SHA = 'ad235f2ad95ba0de0352e170f3e5f4e7111beda52284ac6a315cbe344bc125e9'


def direct_router(early=False, prefetch=False):
    if early and prefetch: raise ValueError('distinct instruction experiments')
    source = pinned(ROOT/'rtl/m5/pa_m5_obi_router.sv', ROUTER_SHA).decode()
    source = once(source, 'module pa_m5_obi_router (',
                  'module pa_m5_obi_router #(parameter bit DirectResponse = 1\'b0) (')
    source = once(source, 'assign host_gnt_o = state_q == Idle && host_req_i && !stop_i;',
        '''// Only instruction ports opt in. A completed owned response may hand
  // the single request slot directly to a new request at the SAME edge.
  // Stop/abort always prevents new admission, never discards old ownership.
  assign host_gnt_o = (state_q == Idle ||
      (DirectResponse && state_q == WaitResponse && target_rvalid_i[route_q])) &&
      host_req_i && !stop_i;''')
    source = once(source, 'assign host_rvalid_o = state_q == Respond;',
        'assign host_rvalid_o = DirectResponse ? (state_q == WaitResponse && target_rvalid_i[route_q]) : state_q == Respond;')
    source = once(source, 'assign host_rdata_o = response_q;',
        'assign host_rdata_o = DirectResponse ? target_rdata_i[route_q] : response_q;')
    source = once(source, 'assign host_err_o = error_q;',
        'assign host_err_o = DirectResponse ? target_err_i[route_q] : error_q;')
    source = once(source, '        state_q <= Respond;', '''        if (DirectResponse) begin
          if (host_gnt_o) begin
            route_q <= host_addr_i[31:28] == 4'h4;
            addr_q <= host_addr_i; data_q <= host_wdata_i;
            we_q <= host_we_i; be_q <= host_be_i;
            state_q <= Send;
          end else state_q <= Idle;
        end else state_q <= Respond;''')
    source = once(source, 'endmodule', '''`ifndef SYNTHESIS
  logic owned_q;
  always_ff @(posedge clk_i) begin
    if (!rst_ni) owned_q <= 0;
    else begin
      assert (!host_rvalid_o || owned_q);
      assert (!host_gnt_o || !owned_q || host_rvalid_o);
      assert (!host_gnt_o || !stop_i);
      if (host_gnt_o) owned_q <= 1;
      else if (host_rvalid_o) owned_q <= 0;
    end
  end
`endif
endmodule''')
    if early:
        source = once(source, "parameter bit DirectResponse = 1'b0",
                      "parameter bit DirectResponse = 1'b0, parameter bit EarlyLocal = 1'b0")
        source = once(source, '''  assign host_gnt_o = (state_q == Idle ||
      (DirectResponse && state_q == WaitResponse && target_rvalid_i[route_q])) &&
      host_req_i && !stop_i;''', '''  logic can_admit, early_local;
  initial assert (!EarlyLocal || DirectResponse);
  assign can_admit = state_q == Idle ||
      (DirectResponse && state_q == WaitResponse && target_rvalid_i[route_q]);
  // Only a RAM instruction may issue at admission. Its grant means the mirror
  // actually accepted the read, including write-priority backpressure. Other
  // addresses retain the registered Send stage and original owned lifetime.
  assign early_local = EarlyLocal && can_admit && host_addr_i[31:16] == 0;
  assign host_gnt_o = can_admit && host_req_i && !stop_i &&
      (!early_local || target_gnt_i[0]);''')
        source = once(source, "assign target_req_o[0] = state_q == Send && !route_q;",
            "assign target_req_o[0] = (state_q == Send && !route_q) || (early_local && host_req_i && !stop_i);")
        for signal, old, new in (('addr', 'addr_q', 'host_addr_i'), ('we', 'we_q', 'host_we_i'),
                                 ('be', 'be_q', 'host_be_i'), ('wdata', 'data_q', 'host_wdata_i')):
            source = once(source, f'assign target_{signal}_o = {old};',
                          f'assign target_{signal}_o = early_local ? {new} : {old};')
        if source.count('state_q <= Send;') != 2: raise ValueError('ambiguous admission states')
        source = source.replace('state_q <= Send;', 'state_q <= early_local ? WaitResponse : Send;')
    if prefetch:
        source = once(source, "parameter bit DirectResponse = 1'b0",
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
