JesseLevine727/pocketai/(commit log)

2026-09-05 m3: integrate pipelined integer SFPU and full-shape verified chains
2026-09-05 m3: record timing shortfall and harden physical qualification harness
    [m3_run.py]
2026-09-05 m4: pin GPT-2 references and expose fixed-range quantization failures
    [fetch_m4_data.py, fetch_m4_model.py]
2026-09-05 m4: qualify held-out W8A8 quality and compact pack; retain long-context range failure
    [export_m4_pack.py]
2026-09-05 m4: implement bounded native and FPGA runtime with independent physical fixtures
    [m4_driver.py, m4_offload.py, m4_run.py, stage_m4_runtime.py]
2026-09-05 m4: batch exact dynamic bridges and pass physical DMA recovery controls
2026-09-05 m4: freeze same-board performance sampling and honest timing boundaries
2026-09-05 m4: audit required physical evidence and reject incomplete or mismatched benchmark samples
2026-09-05 m4: derive honest performance statistics from complete validated raw samples
2026-09-06 m5: qualify actual dual-Ibex DDR and correct delayed-memory core hazards
    Keep staged first-word strobes until grant and gate branch decisions with actual ID execution. Apply hash-checked derivations only to M5 exported sources; frozen dependency trees remain pinned. Add real-hart faults/offsets/abort/remap firmware, independent AXI model, patch-boundary and 84-pass/four-xfail ISA evidence. M5 remains in progress.
    [pa_m5_cluster_top.sv, pa_m5_memory_system.sv]
2026-09-06 m5: stage timing-qualified overlay and autonomous firmware
2026-09-06 perf(m5): qualify 1.565x exact cached-request speedup
    Physical profiling isolated scalar preparation as the dominant cost. Preserve frozen M5 sources and overlay; add exact power-of-two rounding, common-shift metadata preparation, and smoothing reuse in isolated firmware derivations.
    Qualify matched decode, short 2/1/1 full-model requests, exact logits/KV/traces, rejection/recovery, reproducibility, and normal cleanup. Retain the rejected bounded W4A8 screen and evidence-backed cache/queue hardware deferments. No M6 or push.
    [audit_m5_opt.py, collect_m5_opt_evidence.py, export_m5_opt_seed.py, m5_opt_probe.py, m5_opt_profile.py, m5_opt_release_check.py]
2026-09-07 Close three bounded M5 optimization and reassessment cycles
    Retain exact attention/LayerNorm preparation and projection range specialization. Diagnose WFI-gated mcycle undercount; preserve the failed diagnostic and reject the negligible hart-1-only result.
    Qualify original 2/1/1 board requests, full logits/KV/traces, overflow recovery, safe release, fresh binary reproduction, and audited short samples: 16.735890 seconds delivered versus 18.458464 baseline. Preserve both fast harts and the qualified 91 MHz overlay.
    [audit_m5_iterate.py, collect_m5_iterate_evidence.py, m5_iterate_profile.py, m5_iterate_sources.py]
2026-09-07 Characterize frozen M5 across prompts, generation and context
    [m5_sweep_continuation.csv, m5_sweep_samples.csv]
2026-09-08 Close pre-M6 startup and prompt-inclusive performance gates
    Qualify exact cold-cache and scalar row optimizations plus coherent instruction/data mirrors at 91 MHz, DSP0, +0.269 ns WNS. Preserve full GPT-2 outputs, all failed/slower trials, safe DMA ownership and every earlier audit.
    All required repeated short requests and both-prefix maximum-context pairs pass. Record the narrow 3.094 ms short-request margin and unmet optional five-second preparation stretch explicitly. Preserve qualification-source byte identity, including two harmless trailing blank lines. M6 and pushing remain unstarted.
    [audit_m5_startup.py, check_m5_startup_stack.py]
2026-09-08 Checkpoint full M6 SRAM port, functional gates and physical feasibility
    Preserve both fast Ibex harts and full accelerator/memory scope. Add independent SRAM phase data, SPI/UART loader, structural checks, bounded flows and traceable block areas. Record approved research deferrals and the storage stop; M6 remains unqualified.
2026-09-08 Validate M6 single-clock SRAM candidate and add traceable architecture figures
    Restore the required 100-MHz closure contract. Record full dual-hart and consumer-assertion passes, unchanged cycle counts, three bounded banked-memory physical trials, native TikZ/Vivado figures and actual ASIC floorplan evidence. Retain setup, slew and antenna failures; full-chip implementation still needs durable storage. This is an audited intermediate checkpoint, not M6 closure.
    [asic_macros.tsv]
2026-09-08 Diagnose M6 SRAM electrical contract and qualify single-clock loader
    Audit pinned output slew tables without relaxing limits. Retain the unpromoted local-clock experiment, fix explicit PG connections before dont_touch, and regression-check routed leaf topology. Qualify the 1x SPI/dual-fast-Ibex/UART integration with an explicit 10ns simulation period. Refresh primary evidence and preliminary report; M6 100MHz physical closure remains open.
    [m6_100mhz_evidence.py, m6_electrical_screen.py, m6_package_resumed.py, m6_prepare_1x_chip.py]
2026-09-08 Record SRAM output contract and accepted 95 MHz probe checkpoint
    [ss_pins.tsv]
2026-09-10 Checkpoint M6 memory-closure tooling and 95-MHz electrical repair trials
    Bind the bounded extracted-repair and locality-diagnostic experiments to a
    reproducible evidence ledger. The representative 8x SRAM cluster now reaches
    positive setup/hold with zero setup/hold TNS and zero router DRC on the
    read-chain candidate, but slew, capacitance and antenna violations remain, so
    the memory gate and M6 are still open. Adds the renewed three-gate closure
    goal and the Gate-1 repair/diagnostic scripts and unit tests.
2026-09-10 Scope probe transition limit to the SRAM boundary
    The probe SDC applied set_max_transition 0.35 to the whole design, far
    tighter than the sky130 default_max_transition (1.5 ns) or the project's
    MAX_TRANSITION_CONSTRAINT (0.75 ns), and redundant for the SRAM whose
    Liberty already enforces 0.351 ns on its input pins. A read-only STA
    re-analysis of the retained read_chain_route_95_v1 route with a scoped SDC
    collapses 124 slew violations to the 5 real SRAM clock-input slews, and
    exposes 2 SRAM dout-load and 3 fanout violations. Setup/hold/TNS/DRC are
    unchanged; the original SDC and all prior evidence are preserved.
2026-09-10 Recover M6 memory setup margin and document SRAM clock library limit
    Add opt-in extracted-repair knobs (scoped SDC selection, generalized
    macro-load shrink, read-return chain upsize, clock leaf cell) and a
    setup-driven return-path resize. The best retained scoped candidate,
    srfix4_route_95_v1, reaches +0.1725 ns setup / +0.1906 ns hold with zero
    TNS, zero router DRC and zero SRAM dout-load violations.
    Root-cause the remaining five SRAM clk input-slew violations as a
    library/macro corner: the strongest sky130 clock driver (clkinv_16) into
    the macro's 0.241-pF clk pin gives ~0.32 ns rising and ~0.35 ns falling
    at SS, against the macro's 0.351 ns limit. The rising sampling edge
    passes; the fal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
2026-09-10 Close M6 memory fanout with a targeted split; record post-DRT antenna floor
    Add M6_REPAIR_SPLIT_FANOUT: on each single-driver net above the 16-load
    limit, insert one reviewed buffer and move the excess sinks (counting the
    new buffer input) so the net lands at the limit. The best split candidate,
    srfix12_route_95_v1, has zero fanout, zero cap, zero router DRC, setup
    +0.1679 ns and hold +0.1702 ns; only the accepted SRAM clock slew and the
    antenna nets remain.
    Document that the antenna cannot be fully closed with the pinned flow: the
    diode repair precedes detailed routing, repair_antennas has no jumper mode,
    and GRT_ANTENNA_MARGIN 10/50/100 floors the residual at ~7-8 nets. A
    post-DRT antenna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
2026-09-10 Record that post-DRT antenna repair cannot converge in the pinned flow
    Parameterize the route runner timeout and document the post-detailed-routing
    antenna attempt: RepairAntennas on the pre-filler post-DRT state completes,
    but the detailed-routing re-run never converges because the pre-existing
    detailed wires conflict with the inserted diodes and there is no clean
    rip-up/reroute path. The residual antenna count is an open flow limitation,
    not a design or electrical failure.
2026-09-10 Integrate post-DRT antenna repair with rip-up; record residual long-net limit
    Add M6_REPAIR_ANTENNA: insert diodes after the extracted-repair rip-up and
    re-global-route, so the following detailed routing starts clean. Unlike the
    standalone post-DRT attempt, this converges (srfix17_route_95_v1: antenna 13,
    fanout 2, cap 0, setup +0.1334, hold +0.1872, zero DRC). But repair_antennas
    loops 10 iterations on one persistent violation, and the residual is the long
    met4 nets feeding the m6_in_* SRAM input buffers (ratio ~4.06 vs 400), which
    diode insertion cannot reduce. Recorded as an open probe/toolset limitation.
2026-09-10 Try receiver upsize for antenna; document the antenna/cap/fanout trade
    Add M6_REPAIR_ANTENNA_BUFFERS to upsize the m6_in SRAM input receivers to
    buf_16, increasing the antenna victim gate area. This fixes the long met4
    input nets and cuts antenna 16 -> 7 with setup +0.2095 ns, but adds 7 SRAM
    dout-load violations and leaves 7 internal/clock antenna nets that diode
    insertion cannot clear. No single setting closes antenna, cap and fanout
    together; the antenna gate remains an open probe-architecture limitation.
2026-09-10 Control test: relaxing fanout to 24 does not lower the antenna floor
    Add a diagnostic fanout-24 scoped SDC and record the result: with the
    aggressive antenna pass and no split it still reports 12 antenna nets and one
    net above 24 loads, confirming the antenna residual is not fanout-limited.
2026-09-10 Stage the single-clock 1x full-core physical build
    Add the 95-MHz single-clock SDC (soc_1x.sdc) and a physical preparation
    script for the 1x full core. The staged build binds clk_mem_i directly to the
    system and SRAM clocks (no divider), retains all 292 SRAM macros and the full
    portable system. Synthesis, floorplan and PDN complete with zero power-grid
    violations.
    [m6_prepare_physical_1x.py]
2026-09-11 Parameterize physical runner flow name and timeout
    Allow M6_FLOW (default M6Classic) and M6_TIMEOUT (default 1800s) so the
    single-clock 1x full core can use the standard Classic CTS and longer
    placement/routing runs.
2026-09-11 Enlarge 1x core die and parameterize physical runner resources
    Raise DIE_AREA to 13000x14000 with a wider 620-um macro pitch to open routing
    channels, and expose M6_CPUS/M6_MEMORY (defaults 8/12g) so the larger design
    can exceed the 12-GiB container cap. Record that global routing still fails
    with GRT-0118 congestion at both 9100x9900 and 13000x14000.
    [m6_prepare_physical_1x.py]
